shange1217/cicc-10th-tonghui-mosfet-cv-test-system/docs/README.md

# 文档索引

| 文档 | 内容 |
|---|---|
| `control_logic.md` | TH1992/继电器在各测量状态的电压与时序 |
| `relay_truth_table.md` | K1–K10 真值表与接线注意 |
| `test_workflow.md` | 8 步 Task & State Table、状态机、验收标准 |
| `requirements_traceability.md` | 赛题要求 → 代码/固件/文档映射 |
| `measurement_report.md` | 历史测量数据与复现方式 |
| `hardware/wiring.md` | 通道定义、LCR 接口、继电器板供电、安全 |
| `hardware/bom.md` | 关键器件清单 |
| `images/` | 架构图与界面截图 |
| `evidence/` | pytest/tag/环境/哈希证据 |
| `competition/` | 技术文档公开摘要 |

## 阅读顺序

1. `../PORTFOLIO.md`：面试/评审 5 分钟导览；
2. `../README.md`：安装、运行、限制；
3. `hardware/wiring.md`：接线前必读，确认 CH1=漏极、CH2=PCB +5V；
4. `control_logic.md` + `relay_truth_table.md`：上电时序；
5. `test_workflow.md`：界面/流程验收；
6. `requirements_traceability.md`：答辩时对赛题逐条说明。
