shange1217/cicc-10th-tonghui-mosfet-cv-test-system/docs/competition/技术文档_公开版.md

# 技术文档（公开摘要）

> 原 `技术文档_CICC1006571.docx` 含本机用户目录截图与个人文档属性，仅保留在 **private 仓库/比赛材料**，不进入公开包。  
> 本文件是去图、去路径、去个人信息的公开摘要。

## 1. 目标

基于 TH1992 双通道源表、TH2840E 精密 LCR 电桥和 STM32 十路继电器矩阵，测量 TK9J90E 等 MOSFET 的 Ciss / Coss / Crss / Rg。

## 2. 测量原理

- **Ciss**：S 与 D 交流短接，从 G 看进去，Cgs 与 Cgd 并联；
- **Coss**：G 与 S 交流短接，从 D 看进去，Cds 与 Cgd 并联；
- **Crss**：S 悬空，LCR 从 G 注入、D 返回，主要测 Cgd；
- **Rg**：栅极分布电阻与 Ciss 串联，高频下用阻抗实部近似，需短路扣除或四线改造。

## 3. 继电器矩阵

- 9 路基表 K1–K9，10 路板新增 K10：RG(开)/RG(短) 闭合，其余断开；
- 关键复核：**COSS 的 K6 必须闭合**；
- 时序：先切继电器，再开电源；先关电源，再切继电器；
- 真值表见 [`../relay_truth_table.md`](../relay_truth_table.md)。

## 4. 偏置与接线

- TH1992 **CH1 = 漏极 DC_H**，0~100 V；Ciss/Coss/Crss 用 25 V，Rg 用 0 V；
- TH1992 **CH2 = PCB / 继电器板 +5 V**；
- 栅极由 **LCR 内部 DC bias** 提供，当前 Vg=0 V；
- LCR 的 Hp/Hc/Lp/Lc 合并为 `LCR_H` / `LCR_L` 两线；
- 接线见 [`../hardware/wiring.md`](../hardware/wiring.md)。

## 5. 测量条件与结果

- LCR：1 MHz，AC 50 mV；
- 历史表 5.1 是 **5 次独立测量**；当前软件单次测量内部采样 **10 点**，再取中位数/均值/标准差/极差，两者不是同一统计口径；
- 数据表与复现方式见 [`../measurement_report.md`](../measurement_report.md)。

### 表 5.1 历史测量（5 次）

| 参数 | 测量 1 | 测量 2 | 测量 3 | 测量 4 | 测量 5 | 平均值 |
|---|---|---|---|---|---|---|
| Ciss | 2.08103 nF | 2.00682 nF | 2.06135 nF | 2.06264 nF | 2.04375 nF | 2.051118 nF |
| Coss | 158.278 pF | 163.278 pF | 159.332 pF | 162.462 pF | 160.648 pF | 160.7996 pF |
| Crss | 15.0106 pF | 14.6232 pF | 14.5860 pF | 14.6462 pF | 14.6064 pF | 14.69448 pF |
| Rg(开) | 3.59220 Ω | 3.61242 Ω | 3.59652 Ω | 3.57984 Ω | 3.60426 Ω | 3.597048 Ω |
| Rg(短) | 3.58634 Ω | 3.57698 Ω | 3.59124 Ω | 3.58986 Ω | 3.60012 Ω | 3.588908 Ω |

> 历史数据只用于验证链路；当前硬件与栅极条件需重新测量。

## 6. 软件与固件

- 上位机：PyQt5，SCPI 控制 TH2840E/TH1992，8 步任务流程；
- 固件：STM32F103C8，USART 115200，控制 K1–K10；
- 结果写 SQLite/CSV，包含条件、统计量、原始点与副参数 D/θ；
- 设计说明见 [`../../PORTFOLIO.md`](../../PORTFOLIO.md)。

## 7. AI 使用说明

本项目在文字校对、资料整理和代码审查阶段使用了 AI 辅助；测量方案、硬件设计、接线与最终数据由参赛团队确认。
