shange1217/cicc-10th-tonghui-mosfet-cv-test-system/docs/competition/README.md

# 参考文档（文档包）

- `技术文档_公开版.md`：设计原理、继电器矩阵、实测数据、AI 使用说明（去图/去路径/去个人信息）；
- 控制逻辑整理版见 [`../control_logic.md`](../control_logic.md)。

> 原始 `技术文档_CICC1006571.docx` 含本机用户目录截图与个人文档属性，**不在本包/公开包中**；完整原稿仅在 private 仓库/比赛材料中保留。
