shange1217/cicc-10th-tonghui-mosfet-cv-test-system/docs/relay_truth_table.md

# 继电器真值表（K1–K10）

> 依据：CICC 团队 技术文档表 4.1（K1–K9）＋ `下位机程序_新版_v2/User/relay_control.c`（K10）。
> K10 不在原文档的 9 路基表中，是 10 路板后加的，**已由固件确认，但建议用万用表逐态复核**。

## 1. 引脚

| 继电器 | 端口 | 引脚 |
|---|---|---|
| K1 | GPIOA | PA7 |
| K2 | GPIOA | PA6 |
| K3 | GPIOA | PA5 |
| K4 | GPIOA | PA4 |
| K5 | GPIOA | PA3 |
| K6 | GPIOA | PA2 |
| K7 | GPIOA | PA1 |
| K8 | GPIOA | PA0 |
| K9 | GPIOB | PB0 |
| K10 | GPIOB | PB1 |

`RELAY_ON` = 吸合（闭），`RELAY_OFF` = 释放（开）。

## 2. 状态表

| 状态 | K1 | K2 | K3 | K4 | K5 | K6 | K7 | K8 | K9 | K10 |
|---|---|---|---|---|---|---|---|---|---|---|
| 开路校准 OPEN | 开 | 开 | 开 | 开 | 开 | 开 | 开 | 开 | 开 | 开 |
| 短路校准 SHORT | 闭 | 开 | 开 | 开 | 开 | 开 | 开 | 开 | 开 | 开 |
| CISS | 开 | 闭 | 闭 | 闭 | 闭 | 开 | 闭 | 开 | 开 | 开 |
| COSS | 开 | 闭 | 闭 | 开 | 闭 | **闭** | 开 | 开 | 开 | 开 |
| CRSS | 开 | 闭 | 闭 | 开 | 闭 | 开 | 开 | 开 | **闭** | 开 |
| RG(开) | 开 | 闭 | 闭 | 闭 | 开 | 开 | 开 | 开 | 开 | **闭** |
| RG(短) | 开 | 闭 | 闭 | 闭 | 开 | 开 | 开 | **闭** | 开 | **闭** |

## 3. 复核步骤

1. 断电，万用表蜂鸣档接对应继电器的一组常开触点；
2. 用串口助手发 `OPEN`、`SHORT`、`CISS`、`COSS`、`CRSS`、`RGOPEN`、`RGSHORT`；
3. 每个状态逐路量通断，和上表对比；
4. 重点复核 **COSS 的 K6**（原桌面副本写成 OFF，实机固件是 ON）和 **K10**；
5. 结果记进本文件，改板后重新复核。

## 4. 与上位机的关系

上位机只发状态名（`CISS`/`COSS`/…），不直接控制 K1–K10；
所以继电器映射错位不会在 Python 层暴露，必须靠这份表和实测通断来保证。
