shange1217/cicc-10th-tonghui-mosfet-cv-test-system/docs/hardware/bom.md

# 关键器件清单（BOM）

> 10 路继电器板。数量/位号按当前板卡整理；采购前用原理图/实物复核封装、线圈电压和触点耐压。

## 1. 板卡 BOM

| 位号 | 数量 | 型号 / 规格 | 关键参数 / 耐压 | 作用 / 备注 |
|---|---:|---|---|---|
| K1–K10 | 10 | TE 1462042-8（或兼容 5 V 信号继电器） | 触点 220 VDC（原文档标称）；线圈 5 V，采购前核对 | 信号/高压通道切换，触点电容约 1 pF |
| U1 | 1 | ULN2803A（DIP-18/SOIC-18） | 8 通道，50 V / 500 mA 每通道，内置续流二极管 | 驱动 K1–K8 |
| U2 | 1 | ULN2803A（DIP-18/SOIC-18） | 8 通道，50 V / 500 mA 每通道 | 驱动 K9–K10，余 6 路备用；**10 路必须 2 片，不能只列 1 片** |
| U3 | 1 | MAX3232CSE | 3.3/5 V ↔ RS232 | 上位机串口电平转换 |
| U4 | 1 | STM32F103C8T6 | 3.3 V，64 KB Flash | 继电器时序、USART 命令 |
| R1 | 1 | 100 kΩ，1206，1% | ≥100 V（漏极限流位置） | 漏极高压限流；按实际通道复制 |
| R2 | 1 | 100 kΩ，0603/0805，1% | 栅极下拉 | 防止栅极悬空 |
| C1 | 1 | 1 µF，X7R | ≥100 V | LCR 输入端隔直 |
| C2 | 1 | 100 nF，X7R | ≥100 V | LCR 输入端隔直/补偿 |
| C3 | 1 | 1 nF，C0G/NP0 | ≥100 V | 高频补偿/滤波 |
| J1 | 1 | DB9 母座 | — | RS232 |
| J2/J3 | 1 组 | 香蕉插头（红/黑） | ≥100 V | 高压/测量接线 |
| J4 | 1 | 5 V 电源输入端子 | ≥1 A | 继电器板/PCB 供电 |

> `R1` 的“1 只”是最小功能位号；如果每个漏极通道都串限流，按通道数复制。具体以原理图为准。

## 2. 外部仪器 / 被测件

| 类别 | 型号 | 关键参数 | 作用 |
|---|---|---|---|
| LCR | TH2840E | 1 MHz，AC 50 mV，内部 DC bias | 阻抗/电容测量，栅极 bias |
| 源表 | TH1992 | CH1 0–100 V；CH2 5 V | 漏极偏置、PCB/继电器板供电 |
| DUT | TK9J90E | MOSFET | 被测器件 |

## 3. 采购/核对要点

- **ULN2803 必须 2 片**：每片 8 路，K1–K10 共 10 路；只买 1 片会少 2 路。
- 继电器线圈电压按板卡 5 V 轨选型；触点耐压至少覆盖漏极 100 V，原文档标 220 VDC。
- 高压侧电阻/电容耐压按 ≥100 V 选，不能只看容值。
- 继电器板 5 V 入口建议加自恢复保险丝/OVP；具体见 `wiring.md`。
