shange1217/cicc-10th-tonghui-mosfet-cv-test-system/docs/hardware/wiring.md

# 硬件接线与通道定义

> 依据：分赛区决赛《控制逻辑》与技术文档 CICC 团队。
> 当前实现：TH1992 CH1=漏极 DC_H，CH2=PCB +5 V；栅极由 LCR 内部 DC bias 提供。

## 1. TH1992 通道

| 通道 | 连接 | 电压 | 说明 |
|---|---|---|---|
| CH1（DC_H） | MOSFET 漏极 D | 0~100 V；Ciss/Coss/Crss 用 25 V，RG 用 0 V | 串 100 kΩ 限流 |
| CH2 | PCB / 继电器板 5 V | 5 V（4.5~5.5 V） | 会话期间保持，不用于栅极 |

- 栅极接 **LCR 内部 DC bias**（`BIAS:VOLT`），当前给 0 V；不是 TH1992 CH2；
- 不要用 CH2 驱动栅极；也不要把漏极电压加到 CH2；
- 上电顺序：先切继电器，再开 CH2，最后开 CH1；断电顺序：先关 CH1，再关 CH2，最后继电器回开路。

## 2. LCR 接口

TH2840E 的 Hp/Hc/Lp/Lc 合并为两个端口 `LCR_H` / `LCR_L`：

- 两线制，丢失开尔文四线；pF 级靠开路/短路补偿，Rg（~3.5 Ω）必须做短路扣除或改四线；
- 测量端串隔直电容（1 µF / 100 nF / 1 nF），保护 LCR 输入不受 100 V 直流影响；
- 测量 Ciss/Coss 时 S 端不能接地；
- 栅极偏置由 LCR 内部 bias 提供，接线前确认 LCR bias 输出确实接到栅极。

## 3. 继电器矩阵

- 9 路基表见 `docs/relay_truth_table.md`（K1–K9）；
- 10 路板新增 K10：RG(开)/RG(短) 闭合，其余断开；
- 关键复核：**COSS 的 K6 必须闭合**（旧副本写成 OFF，是错的）。

## 4. 安全

- 漏极 100 V、PCB 5 V；首次上电用限流电源；
- 5 V 轨建议加 eFuse/OVP 或 5.6 V 稳压管 + 自恢复保险丝，TVS 只能防瞬态；
- 继电器板输入建议加下拉，保证 MCU 复位/掉电时继电器回开路；
- 更换接线/夹具后重新做开路/短路校准，并记录残差。
