shange1217/cicc-10th-tonghui-mosfet-cv-test-system/docs/measurement_report.md

# 测量记录

> 数据来自 `技术文档_公开版.md` 表 5.1（最后一张测量表）；测试对象 TK9J90E，环境 20–27 ℃。
> 表 5.1 是 **5 次独立测量**；当前软件单次测量内部采样 **10 点**，两者统计口径不同，不能混写成“每参数 10 次测量”。
> 该表是历史数据，栅极条件与当前系统（LCR 内部 bias=0 V）不同，仅用于核验测量链路；当前系统需重新测量。

| 参数 | 测量 1 | 测量 2 | 测量 3 | 测量 4 | 测量 5 | 平均值 | 手册典型值 |
|---|---|---|---|---|---|---|---|
| Ciss | 2.08103 nF | 2.00682 nF | 2.06135 nF | 2.06264 nF | 2.04375 nF | 2.051118 nF | 2 nF |
| Coss | 158.278 pF | 163.278 pF | 159.332 pF | 162.462 pF | 160.648 pF | 160.7996 pF | 150 pF |
| Crss | 15.0106 pF | 14.6232 pF | 14.5860 pF | 14.6462 pF | 14.6064 pF | 14.69448 pF | 15 pF |
| Rg(开) | 3.59220 Ω | 3.61242 Ω | 3.59652 Ω | 3.57984 Ω | 3.60426 Ω | 3.597048 Ω | 3.5 Ω |
| Rg(短) | 3.58634 Ω | 3.57698 Ω | 3.59124 Ω | 3.58986 Ω | 3.60012 Ω | 3.588908 Ω | 3.5 Ω |

## 复现方式

1. 连接 TH2840E、TH1992、STM32；
2. 设 `MOS_DRAIN_SETTLE_MS=1000`、`MOS_DEVICE_SN=TK9J90E`；
3. 运行 `python main.py` → 测试流程 → 运行全部；
4. 结果同时写界面表、`data/measurements.db`、桌面 CSV；
5. 与上表对比，偏差 >10% 时检查夹具、补偿、继电器状态。

## 注意

- **分析推断（不是原文档结论）**：Rg(开) 3.597 Ω 与 Rg(短) 3.589 Ω 只差约 0.23%，若“短”态真的把栅极短路，阻值应有明显变化；因此怀疑短路继电器/夹具未真正短接，或 3.5 Ω 主要是引线/接触电阻。原技术文档只给了这张数据表，没有下这个结论，必须用万用表核对；
- 历史数据不能直接当当前指标，需重新做重复性（建议 3 器件 × 10 次）。
