shange1217/cicc-10th-tonghui-mosfet-cv-test-system/docs/evidence/test-names.txt

test_measurement.py:23: test_summarize_basic_stats
test_measurement.py:34: test_summarize_rejects_too_few_points
test_measurement.py:39: test_spread_warning_threshold
test_measurement.py:45: test_no_warning_for_stable_points
test_measurement.py:50: test_condition_text_contains_conditions
test_measurement.py:58: test_secondary_value_is_persisted_in_row
test_measurement.py:66: test_rg_open_short_consistency_warning
test_measurement.py:75: test_csv_roundtrip
test_scpi.py:6: test_list_sweep_builds_total_freq_and_mode
test_scpi.py:15: test_func_uses_manual_parameter_pairs
test_scpi.py:21: test_average_and_range_commands
test_scpi.py:26: test_list_sweep_points_clamped_to_minimum
test_scpi.py:31: test_list_sweep_rejects_reversed_range
test_scpi.py:36: test_list_sweep_rejects_non_positive_start
test_storage.py:20: test_store_roundtrip_and_csv
test_storage.py:54: test_finish_unknown_run_is_harmless
test_tasks.py:6: test_task_list_is_eight_steps
test_tasks.py:12: test_progress_label_and_fraction
test_tasks.py:24: test_pause_resume_only_from_running
test_tasks.py:35: test_stop_and_fail_states
test_tasks.py:47: test_index_is_clamped
test_th1992.py:6: test_rejects_overvoltage_on_drain
test_th1992.py:11: test_rejects_high_voltage_on_pcb_rail
test_th1992.py:17: test_accepts_normal_conditions
test_th1992_power.py:13: test_terminator_is_nl_per_manual
test_th1992_power.py:17: test_output_on_opens_pcb_before_drain
test_th1992_power.py:26: test_pcb_on_is_idempotent
test_th1992_power.py:33: test_drain_only_does_not_touch_pcb
test_th1992_power.py:45: test_output_off_zeroes_then_disconnects
test_th1992_power.py:54: test_rejects_overvoltage_on_drain
test_th1992_power.py:60: test_rejects_overvoltage_on_pcb_rail
test_th2840.py:6: test_param_pairs_use_manual_syntax
test_th2840.py:12: test_average_uses_med_token
test_th2840.py:21: test_load_calibration_is_hard_disabled
test_th2840.py:30: test_poll_secondary_units_for_rs_and_gp
test_watchdog.py:6: test_watchdog_fires_after_consecutive_failures
test_watchdog.py:19: test_watchdog_resets_on_success
test_watchdog.py:35: test_watchdog_stop_is_idempotent
