shange1217/cicc-10th-tonghui-mosfet-cv-test-system/CHANGELOG.md

# Changelog

## v1.4.2 — 2026-11-06

- 干净历史：不包含原技术文档 docx，公开摘要替代
- BOM 增加位号/数量/耐压；10 路继电器使用 2 片 ULN2803
- UI 截图改为 n=10/50 mV 并加 DEMO 标注
- 证据统一 UTF-8 no BOM / LF

## v1.4.1 — 2026-11-05

- 增加 PORTFOLIO 导览、架构图、界面截图
- 清理技术文档作者/自定义元数据（CICC Team）
- 准备公开仓库与 Release 文档包

## v1.4.0 — 2026-11-05

- 按分赛区决赛《控制逻辑》/技术文档回退通道定义：
  - CH1=漏极 DC_H，CH2=PCB +5 V
  - 栅极改回 LCR 内部 DC bias（当前 0 V）
  - 恢复 `pcb_on/pcb_off`、`output_on(drain, pcb)`
- 同步主窗口、测试、接线/控制逻辑/赛题映射文档

## v1.3.5 — 2026-11-05

- 删除不参与运行的 `_attic` 死代码
- 删除误导性的 `TH1992.pcb_on/pcb_off` 别名
- 删除未使用的 `_current_freq`/`set_display_mode`
- 修正副参数 `RS`/`GP` 的单位显示
- 测试增至 38 项

## v1.3.4 — 2026-11-05

- README/requirements 明确 TH1992 回显握手未实现（功能缺口）
- 明确负载校准不可用：按钮禁用、方法抛 NotImplementedError、不发 CORR:LOAD
- 取消 Vds 阶梯扫描/CV 曲线功能，删除 `_attic/cv_widget.py`；保留频率列表扫描

## v1.3.3 — 2026-11-05

- 副参数 D/θ 写入 SQLite/CSV（旧库自动加列）
- Rg(开)/Rg(短) 自动一致性告警
- 禁用未定义的负载校准按钮
- 测试增至 37 项

## v1.3.2 — 2026-11-05

- 按 TH2840 V1.3.1 手册修正：FUNC:IMP 参数组合、LIST:MODE、APER 平均、FUNC:IMP:RANG
- 负载校准查询改为 CORR:LOAD:STAT?；手册未定义 CORR:LOAD 执行命令
- 目录统一为 th2840_control
- 补充 TH1992 回显握手问题

## v1.3.1 — 2026-11-05

- LCR 驱动类/文件统一改为 `TH2840`（`device/th2840.py`、`TH2840_SCPI`）
- 上位机标题、按钮、日志、预检型号统一为 TH2840E
- 移除历史阶段对比说明，文档只描述当前系统
- 补充 `.env`/密钥不入库约束

## v1.3.0 — 2026-11-05

- 8 步测试流程：自检、开路、短路、Ciss、Coss、Crss、Rg(开)、Rg(短)
- 任务进度条、步内采样进度、单步执行、暂停/继续、协作式停止
- 五参数常驻结果表（主值 / 副值 D 或 θ / n / 极差）
- 显式状态机 `core/tasks.py`，单步执行也走预检门禁
- 按分赛区决赛控制逻辑：TH1992 CH1=漏极、CH2=PCB +5 V；栅极由 LCR 内部 bias 给 0 V

## v1.2.1 — 2026-11-01

- 按控制逻辑整理版与 TH1992 手册 V1.0.6 修正：
  - 串口结束符 NL(0x0A)
  - 输出命令 `OUTP1:STAT ON/OFF`
  - 关闭前先回 0 V
  - RG 的 CH1 为 0 V 输出开启

## v1.2.0 — 2026-10-29

- 偏置/继电器等待可配置（`MOS_DRAIN_SETTLE_MS` / `MOS_RELAY_SETTLE_MS`）
- CH2 会话保活；阶段间只关 CH1，保留 5 V
- STM32 连接看门狗
- SQLite 测量记录与 CSV 导出

## v1.1.0 — 2026-10-29

- 测量条件/统计/CSV：中位数、均值、标准差、极差、原始点
- 测前自检：`*IDN?`、补偿状态
- 互斥、协作取消、关窗断电
- 死代码下线，依赖/测试/git 初始化

## v1.0.0 — 2026-07

- 初始版本：串口连接、开路/短路校准、MOS 测试、频率扫描、日志
