shange1217/cicc-10th-tonghui-mosfet-cv-test-system/(commit log)

2026-11-05 v1.4.2: clean public history, public technical summary, UTF-8 evidence
    [git-diff-stat.txt, git-diff-th1992.txt]
2026-11-05 v1.4.2: evidence, BOM and docs cleanup
    [git-diff-stat.txt, git-diff-th1992.txt]
